jnwatts/USBPass/README.md

USBPass
=======

USB HID Password Storage Device

Project page: http://sroz.net/projects/usbpass
