jnwatts/USBPass/hw/Oshpark RevA1/usbpass BOM RevA1.ods

Id | Designator | Package | Quantity | Designation | Supplier and ref
1 | IC1 | TQFP32 | 1 | ATMEGA32U2 | ATMEGA32U2-AURCT-ND
2 | C1 | SM0805 | 1 | 10uF_10% | 445-7660-1-ND
3 | C2,C3,C4 | SM0805 | 3 | 0.1uF | 445-7534-1-ND
4 | SW3,SW2,SW1 | TL3315NF100Q | 3 | SW_PUSH2 | EG4620CT-ND
5 | R1,R2 | SM0402 | 2 | 22_5% | P22GCT-ND
6 | R3,R7,R8,R9 | SM0402 | 4 | 10K | P10KJCT-ND
7 | R4,R5,R6 | SM0402 | 3 | 0 | P0.0JCT-ND
