jnwatts/USBPass/hw/usbpass.sch

## KiCad design hw/usbpass.sch (2013-01-27)

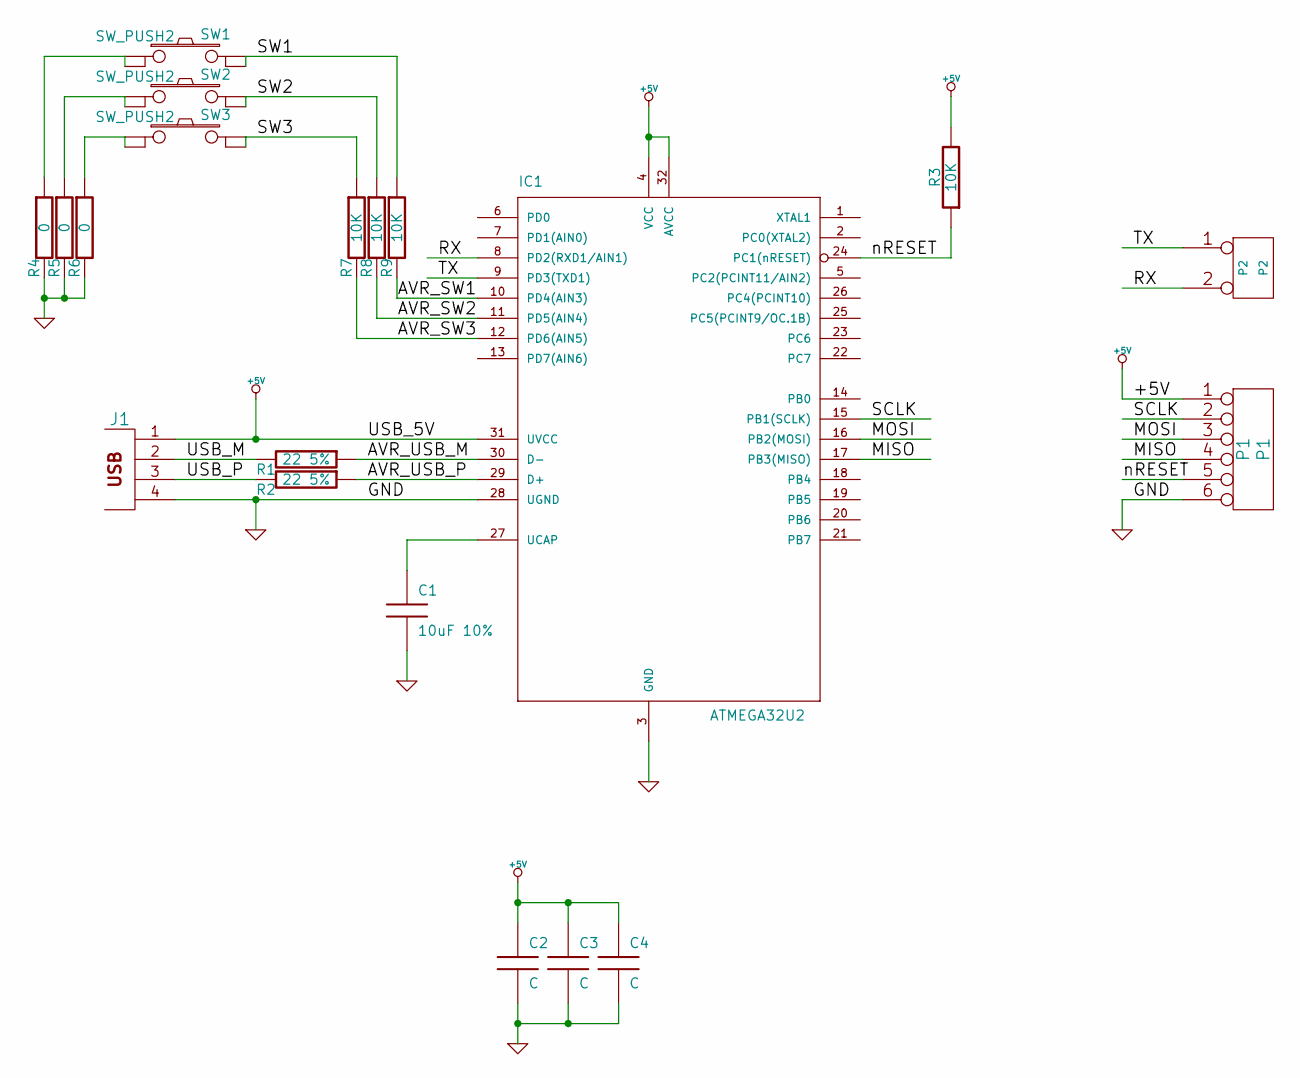
[picture p1: schematic usbpass.sch]

Parts:
C1: 10uF 10%
C2, C3, C4: C
IC1: ATMEGA32U2; TQFP32
J1: USB_2
P1: P1
P2: P2
R1, R2: 22 5%
R3, R7, R8, R9: 10K
R4, R5, R6: 0
SW1, SW2, SW3: SW_PUSH2

Connections:
+5V: C2.1, C3.1, C4.1, IC1.4 (VCC), IC1.31 (UVCC), IC1.32 (AVCC), J1.1, P1.1, R3.2
AVR_SW1: IC1.10 (PD4(AIN3)), R9.2
AVR_SW2: IC1.11 (PD5(AIN4)), R8.2
AVR_SW3: IC1.12 (PD6(AIN5)), R7.2
AVR_USB_M: IC1.30 (D-), R1.1
AVR_USB_P: IC1.29 (D+), R2.1
GND: C1.2, C2.2, C3.2, C4.2, IC1.3 (GND), IC1.28 (UGND), J1.4, P1.6, R4.2, R5.2, R6.2
MISO: IC1.17 (PB3(MISO)), P1.4
MOSI: IC1.16 (PB2(MOSI)), P1.3
unnamed: C1.1, IC1.27 (UCAP)
unnamed: R4.1, SW1.1, SW1.2
unnamed: R5.1, SW2.1, SW2.2
unnamed: R6.1, SW3.1, SW3.2
RX: IC1.8 (PD2(RXD1/AIN1)), P2.2 (PM)
SCLK: IC1.15 (PB1(SCLK)), P1.2
SW1: R9.1, SW1.3, SW1.4
SW2: R8.1, SW2.3, SW2.4
SW3: R7.1, SW3.3, SW3.4
TX: IC1.9 (PD3(TXD1)), P2.1
USB_M: J1.2, R1.2
USB_P: J1.3, R2.2
nRESET: IC1.24 (PC1(nRESET)), P1.5, R3.1
