jnwatts/USBPass/(commit log)

2013-01-27 Adding rev A1 of hw
    [usbpass.brd, usbpass.sch]
2013-02-09 Adding BOM and Notes for RevA1
    [usbpass BOM RevA1.ods]
2013-02-10 Copied prototype code to Lib
2013-02-10 Timer: First-pass attempt at getting 8Hz and 1ms times
2013-02-10 Got prototype code integrated and running
    Timer: Not quite right, 40ms resolution works ok at least
    Button: Works (as well timer allows)
    Setting: Works
    Action: Works
2013-02-14 USBPass: Only send null-key if repeated or no more keys, and lay ground work for ReportType Feature
2013-02-14 Descriptors: Add reminder to measure power usage (not sure exactly how...)
2013-02-16 USBPass: Oops, only printf if DEBUG is defined
2013-02-17 HIDKEY: Add method for printing exactly N characters
2013-02-17 KEYSTORE: Print no more than sizeof({key,name})
2013-02-17 USBPass: Implement software reset
    [USBPass.c, USBPass.h]
2013-02-21 PINMAP: Expand button enum to include "long" action
2013-02-21 USBPass: Implement API for setting button actions
2013-02-24 hw: Note items needed on boot-strap jig
2013-02-24 libusbpass: Add udev rule file for accessing device as user
2013-02-25 libusbpass: Disable serial-number based open(), does not work for some reason =(
    [usbpassdevice.cpp]
